zck15/CLLFO-SHA-3/(commit log)

2024-08-27 - Correct hardware README claim for wire-transition security: Aligned hardware README security claim with paper, changing from wire-transition to register-transition security. - Add /figs folder to f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
2024-08-28 Added files and documentation for leakage assessments: - Added PROLEAD configuration files, output reports, and data processing scripts; - Included documentation for PROLEAD and VerMI; - Added Verilo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
    [FIFO2.v, keccak_top.v]
2024-09-02 update TVLA trace collection script
